icebreaker-fpga/icecrash/README.md

# iCECrash

The Retro game console and demoscene motherboard for iCEBreaker-bitsy.

This project has moved to [Codeberg](https://codeberg.org/icebreaker-fpga/icecrash)
