icebreaker-fpga/icecrash/hardware/v0.1a/icecrash.kicad_pcb

## KiCad design hardware/v0.1a/icecrash.kicad_pcb (2021-08-17, last stored version)

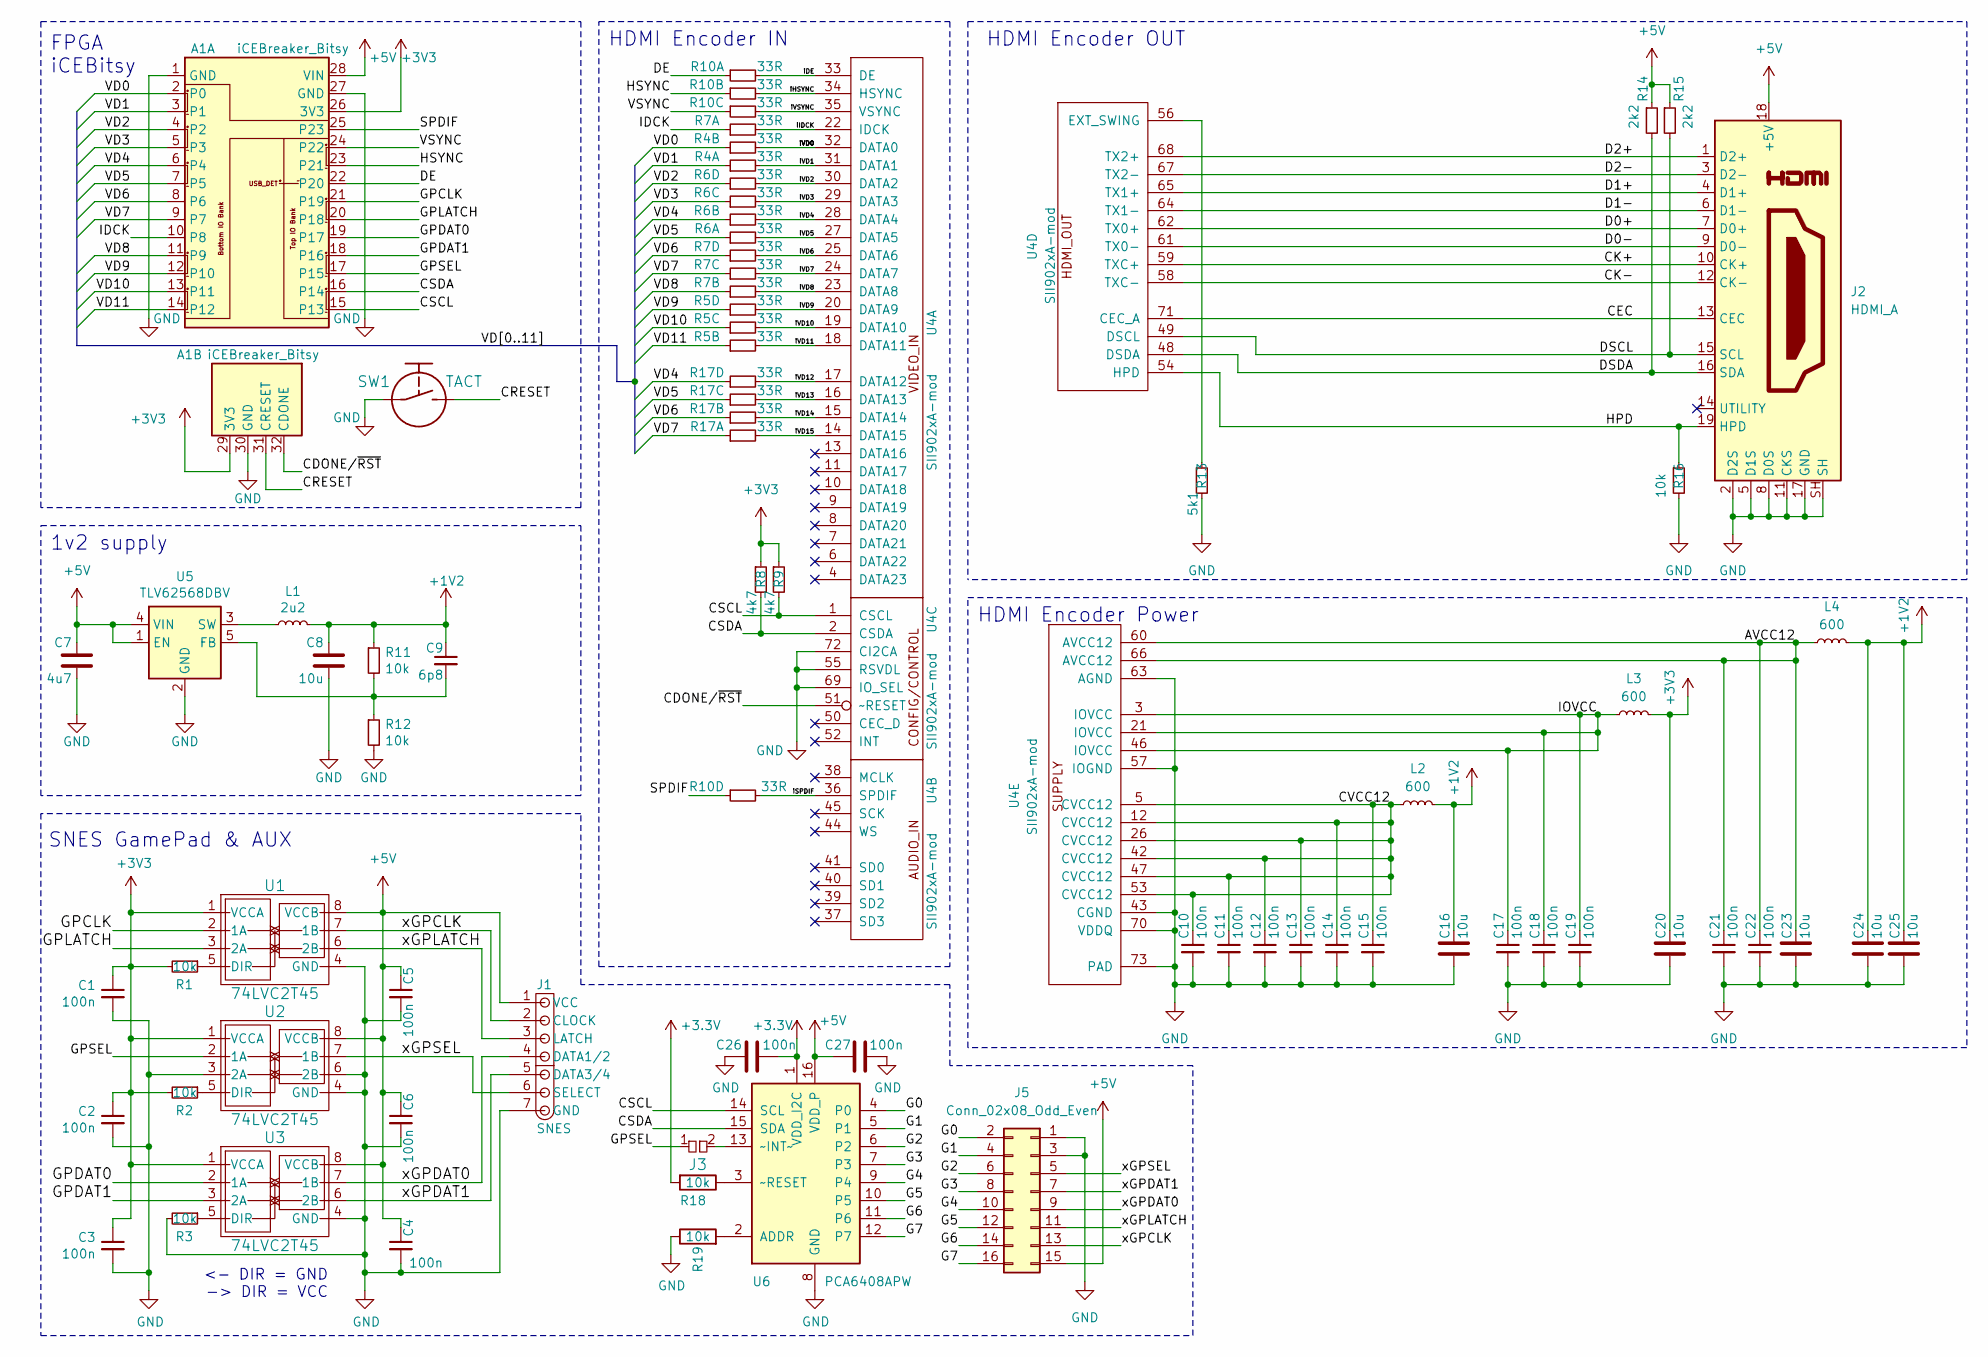
[picture p1: schematic icecrash.kicad_sch]

Parts:
A1: iCEBreaker_Bitsy
C1, C2, C3, C4, C5, C6, C10, C11, C12, C13, C14, C15, C17, C18, C19, C21, C22: 100n; C_0402
C7: 4u7; C_0603
C8, C16, C20, C23, C24, C25: 10u; C_0603
C9: 6p8; C_0402
C26, C27: 100n; C_0402_1005Metric; MPN TMK105BJ104KV-F
J1: SNES
J2: HDMI_A; HDMI-10029449-111RLF
J3: pkl_jumper; J_0603
J5: Conn_02x08_Odd_Even; PinHeader_2x08_P2.54mm_Horizontal
L1: 2u2; L_0805
L2, L3, L4: 600; L_0402
R1, R2, R3, R11, R12, R16: 10k; R_0402
R4, R5, R6, R7, R10, R17: 33R; R_Array_Convex_4x0402
R8, R9: 4k7; R_0402
R13: 5k1; R_0402
R14, R15: 2k2; R_0402
R18, R19: 10k; R_0402_1005Metric; MPN RC0402FR-1310KL
SW1: TACT; SW_SPST_3x4x2.5
U1, U2, U3: 74LVC2T45; SOT-833-1
U4: SII902xA-mod; QFN-72-1EP_10x10mm_P0.5mm_EP6x6mm_ThermalVias
U5: TLV62568DBV; SOT-23-5
U6: PCA6408APW; TSSOP-16_4.4x5mm_P0.65mm; MPN PCA6408APW

Connections:
+1V2: C8.1, C9.1, C16.1, C24.1, C25.1, L1.1, L2.1, L4.1, R11.1
+5V: A1.28 (VIN), C4.1, C5.1, C6.1, C7.1, C27.1, J1.1 (VCC), J2.18 (+5V), J5.15, R14.1, R15.1, U1.8 (VCCB), U2.8 (VCCB), U3.8 (VCCB), U5.1 (EN), U5.4 (VIN), U6.16 (VDD_P)
/AVCC12: C21.1, C22.1, C23.1, L4.2, U4.60 (AVCC12), U4.66 (AVCC12)
/CDONE/~RST: A1.32 (CDONE), U4.51 (~RESET)
/CEC: J2.13 (CEC), U4.71 (CEC_A)
/CK+: J2.10 (CK+), U4.59 (TXC+)
/CK-: J2.12 (CK-), U4.58 (TXC-)
/CRESET: A1.31 (CRESET), SW1.2
/CSCL: A1.15 (P13), R9.2, U4.1 (CSCL), U6.14 (SCL)
/CSDA: A1.16 (P14), R8.2, U4.2 (CSDA), U6.15 (SDA)
/CVCC12: C10.1, C11.1, C12.1, C13.1, C14.1, C15.1, L2.2, U4.5 (CVCC12), U4.12 (CVCC12), U4.26 (CVCC12), U4.42 (CVCC12), U4.47 (CVCC12), U4.53 (CVCC12)
/D0+: J2.7 (D0+), U4.62 (TX0+)
/D0-: J2.9 (D0-), U4.61 (TX0-)
/D1+: J2.4 (D1+), U4.65 (TX1+)
/D1-: J2.6 (D1-), U4.64 (TX1-)
/D2+: J2.1 (D2+), U4.68 (TX2+)
/D2-: J2.3 (D2-), U4.67 (TX2-)
/DE: A1.22 (P20), R10.1
/DSCL: J2.15 (SCL), R15.2, U4.49 (DSCL)
/DSDA: J2.16 (SDA), R14.2, U4.48 (DSDA)
/G0: J5.2, U6.4 (P0)
/G1: J5.4, U6.5 (P1)
/G2: J5.6, U6.6 (P2)
/G3: J5.8, U6.7 (P3)
/G4: J5.10, U6.9 (P4)
/G5: J5.12, U6.10 (P5)
/G6: J5.14, U6.11 (P6)
/G7: J5.16, U6.12 (P7)
/GPCLK: A1.21 (P19), U1.2 (1A)
/GPDAT0: A1.19 (P17), U3.2 (1A)
/GPDAT1: A1.18 (P16), U3.3 (2A)
/GPLATCH: A1.20 (P18), U1.3 (2A)
/GPSEL: A1.17 (P15), J3.1, U2.2 (1A)
/HPD: J2.19 (HPD), R16.1, U4.54 (HPD)
/HSYNC: A1.23 (P21), R10.3
/IDCK: A1.10 (P8), R7.1
/IOVCC: C17.1, C18.1, C19.1, L3.2, U4.3 (IOVCC), U4.21 (IOVCC), U4.46 (IOVCC)
/SPDIF: A1.25 (P23), R10.7
/VD0: A1.2 (P0), R4.3
/VD1: A1.3 (P1), R4.1
/VD2: A1.4 (P2), R6.7
/VD3: A1.5 (P3), R6.5
/VD4: A1.6 (P4), R6.3, R17.7
/VD5: A1.7 (P5), R6.1, R17.5
/VD6: A1.8 (P6), R7.7, R17.3
/VD7: A1.9 (P7), R7.5, R17.1
/VD8: A1.11 (P9), R7.3
/VD9: A1.12 (P10), R5.7
/VD10: A1.13 (P11), R5.5
/VD11: A1.14 (P12), R5.3
/VSYNC: A1.24 (P22), R10.5
/iDE: R10.2, U4.33 (DE)
/iHSYNC: R10.4, U4.34 (HSYNC)
/iIDCK: R7.2, U4.22 (IDCK)
/iSPDIF: R10.8, U4.36 (SPDIF)
/iVD0: R4.4, U4.32 (DATA0)
/iVD1: R4.2, U4.31 (DATA1)
/iVD2: R6.8, U4.30 (DATA2)
/iVD3: R6.6, U4.29 (DATA3)
/iVD4: R6.4, U4.28 (DATA4)
/iVD5: R6.2, U4.27 (DATA5)
/iVD6: R7.8, U4.25 (DATA6)
/iVD7: R7.6, U4.24 (DATA7)
/iVD8: R7.4, U4.23 (DATA8)
/iVD9: R5.8, U4.20 (DATA9)
/iVD10: R5.6, U4.19 (DATA10)
/iVD11: R5.4, U4.18 (DATA11)
/iVD12: R17.8, U4.17 (DATA12)
/iVD13: R17.6, U4.16 (DATA13)
/iVD14: R17.4, U4.15 (DATA14)
/iVD15: R17.2, U4.14 (DATA15)
/iVSYNC: R10.6, U4.35 (VSYNC)
/xGPCLK: J1.2 (CLOCK), J5.13, U1.7 (1B)
/xGPDAT0: J1.4 (DATA1/2), J5.9, U3.7 (1B)
/xGPDAT1: J1.5 (DATA3/4), J5.7, U3.6 (2B)
/xGPLATCH: J1.3 (LATCH), J5.11, U1.6 (2B)
/xGPSEL: J1.6 (SELECT), J5.5, U2.7 (1B)
GND: A1.1 (GND), A1.27 (GND), A1.30 (GND), C1.2, C2.2, C3.2, C4.2, C5.2, C6.2, C7.2, C8.2, C10.2, C11.2, C12.2, C13.2, C14.2, C15.2, C16.2, C17.2, C18.2, C19.2, C20.2, C21.2, C22.2, C23.2, C24.2, C25.2, C26.2, C27.2, J1.7 (GND), J2.2 (D2S), J2.5 (D1S), J2.8 (D0S), J2.11 (CKS), J2.17 (GND), J2.SH, J5.1, J5.3, R3.2, R12.2, R13.2, R16.2, R19.1, SW1.1, U1.4 (GND), U2.3 (2A), U2.4 (GND), U2.6 (2B), U3.4 (GND), U4.43 (CGND), U4.55 (RSVDL), U4.57 (IOGND), U4.63 (AGND), U4.69 (IO_SEL), U4.70 (VDDQ), U4.72 (CI2CA), U4.73 (PAD), U5.2 (GND), U6.8 (GND)
unnamed: C9.2, R11.2, R12.1, U5.5 (FB)
unnamed: J3.2, U6.13 (~INT~)
unnamed: L1.2, U5.3 (SW)
unnamed: R1.1, U1.5 (DIR)
unnamed: R2.1, U2.5 (DIR)
unnamed: R3.1, U3.5 (DIR)
unnamed: R13.1, U4.56 (EXT_SWING)
unnamed: R18.1, U6.3 (~RESET)
unnamed: R19.2, U6.2 (ADDR)

Notes on the sheet:
FPGA iCEBitsy
1v2 supply
SNES GamePad & AUX
<- DIR = GND -> DIR = VCC
HDMI Encoder IN
HDMI Encoder Power
HDMI Encoder OUT

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
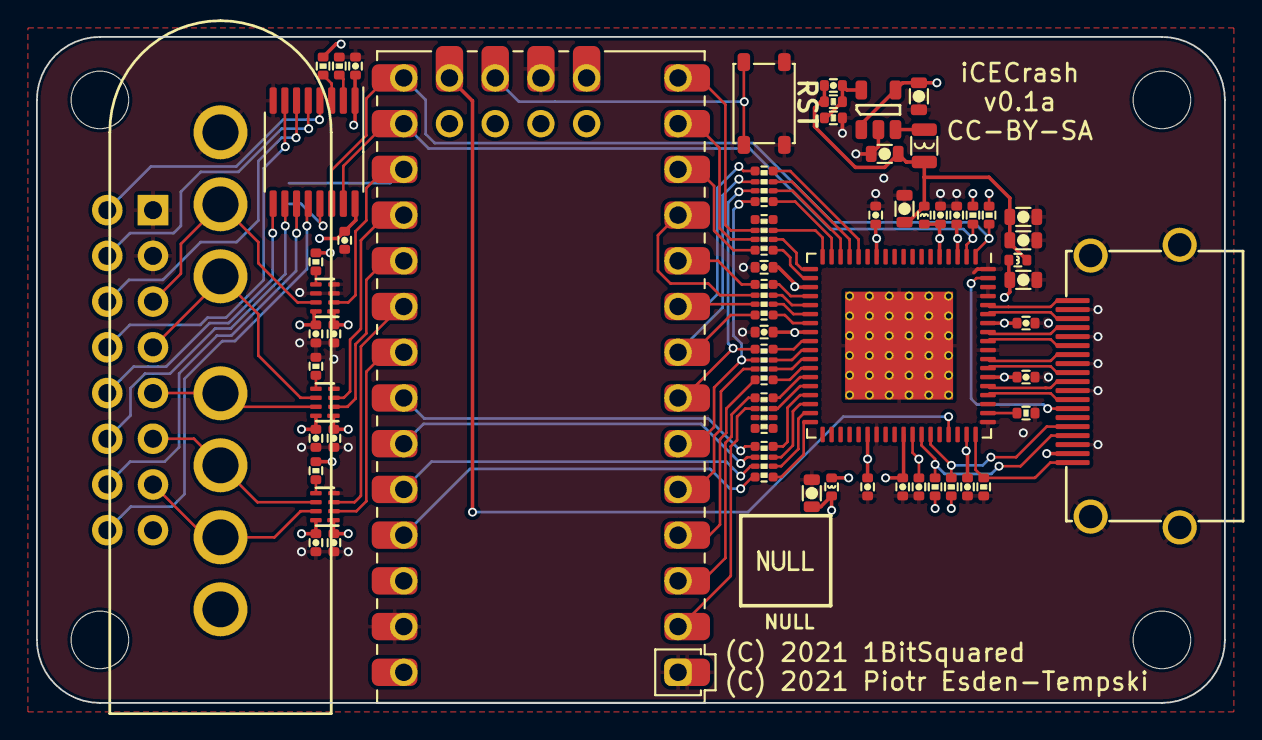
[picture p2: board icecrash.kicad_pcb from above]

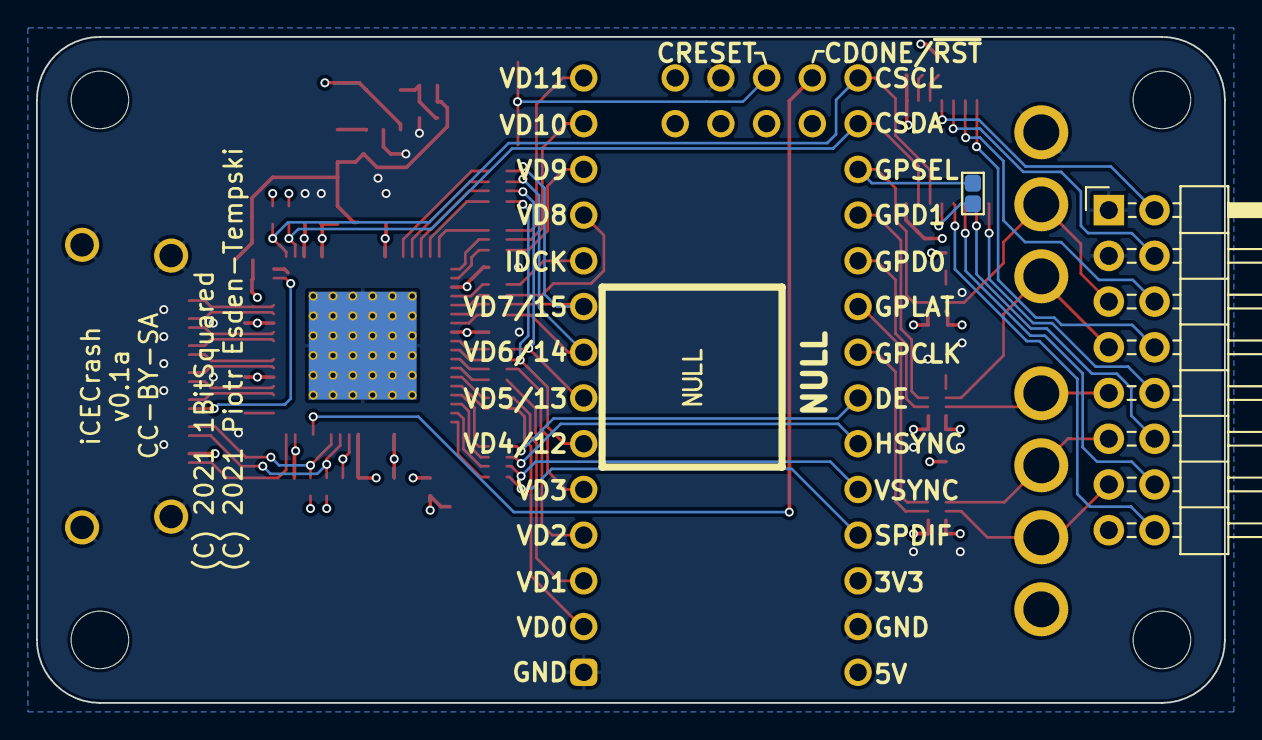
[picture p3: board icecrash.kicad_pcb from below]

Board: 4 copper layers, 66.0 x 37.0 mm, 62 parts (2 on the bottom side), 88 nets.
