icebreaker-fpga/icecrash/(commit log)

2021-07-07 Initial commit.
    [icedemo.kicad_pcb, icedemo.kicad_sch]
2021-07-08 Added schematic PDF.
2021-07-16 First draft of the schematic.
    Connected all the remaining pins of the encoder chip.
    Replaced the SNES connector generic symbol with a dedicated one.
    Added ESD protection to the HDMI connector. (might delete later ;) )
    Added level shifters for the SNES interface.
    [icedemo.kicad_sch]
2021-07-16 Removed ESD protection. It is a toy after all...
    * I think it is worth saving $4 over the ESD protection in this case.
    Also updated the schematic PDF.
    [icedemo.kicad_sch]
2021-07-23 Improved schematic and started layout.
    * Added inline termination resistors.
    * Corrected a mistake in the encoder symbol.
    (Pin 15/13 and missing Pin 70)
    * Preliminary positioning of the parts on the PCB.
    * Started routing the input data pins.
    [icedemo.kicad_pcb, icedemo.kicad_sch]
2021-07-28 First routing pass.
    State after Electronics Let's Play stream.
    [icedemo.kicad_pcb, icedemo.kicad_sch]
2021-08-11 Improved layout from Aug 10th stream.
    Added GPIO expander and AUX connector.
    Compressed board a bit.
    [icedemo.kicad_pcb, icedemo.kicad_sch]
2021-08-11 Renamed project to iCECrash.
    [icecrash.kicad_pcb, icecrash.kicad_sch]
2021-08-13 Changed the HDMI encoder wiring a bit.
    It is better to leave the sync signals alone. We can double assign some
    of the data pins to gain access to a bunch of additional video data
    modes. Now `d[7:4]` are also connected to `d[15:12]`.
    [icecrash.kicad_pcb, icecrash.kicad_sch]
2021-08-14 More compression work. Fixed a few bugs, added silkscreen.
    [icecrash.kicad_pcb, icecrash.kicad_sch]
2021-08-17 Aligned pin headers to the PCB center.
    [icecrash.kicad_pcb]
2021-08-17 Updated copper fills.
    [icecrash.kicad_pcb]
2026-05-24 We have moved to Codeberg see README.
    [icecrash.kicad_pcb, icecrash.kicad_sch]
