icebreaker-fpga/icecrash/(notices)

Notices in the files:
hardware/v0.1a/icecrash.kicad_pcb:
(C) 2021 1BitSquared
(C) 2021 Piotr Esden-Tempski
License: CC-BY-SA
CC-BY-SA
